Adrian-codeg/Mechatronics-robotics/README.md

Aim and Objectives:
Building a 3 degree-of-freedom robot for drawing on the board and return to inital point.

Method:
The project included the following components:

CAD design a 3 degree-of-freedom robot for drawing and assemble thems with motors and microcontroller.

Programming in the Arduino.

Communicating between them through a serial communication.

Adding some other addtionally features for more points.

Result:





Untitled video - Made with Clipchamp (2)

Note:
The CAD design was done on Fusion360: [https://github.com/Adrian-codeg/Mechatronics-robotics/blob/main/Mechatronics%20designs%20group%202.zip](https://grabcad.com/library/mechatronics-robotics-1)

Link for final result: https://www.youtube.com/watch?v=gOB_Nq9NREc
Code for arduino: https://github.com/Adrian-codeg/Mechatronics-robotics/tree/main/planB_v4
