Adrian-codeg/Mechatronics-robotics/Mechatronics designs on Fusion 360 group 2/down chassis v1 v10.step

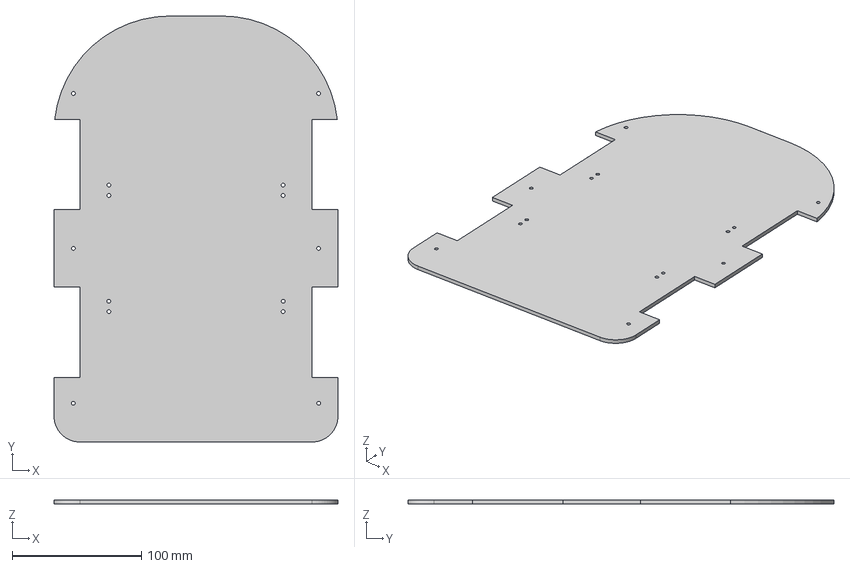
[picture p5: CAD file, 2025-03-02]
Mechatronics designs on Fusion 360 group 2/down chassis v1 v10.step
220.0 x 330.0 x 3.20 mm
