Adrian-codeg/Mechatronics-robotics/Mechatronics designs on Fusion 360 group 2/first part of the arm v18.step

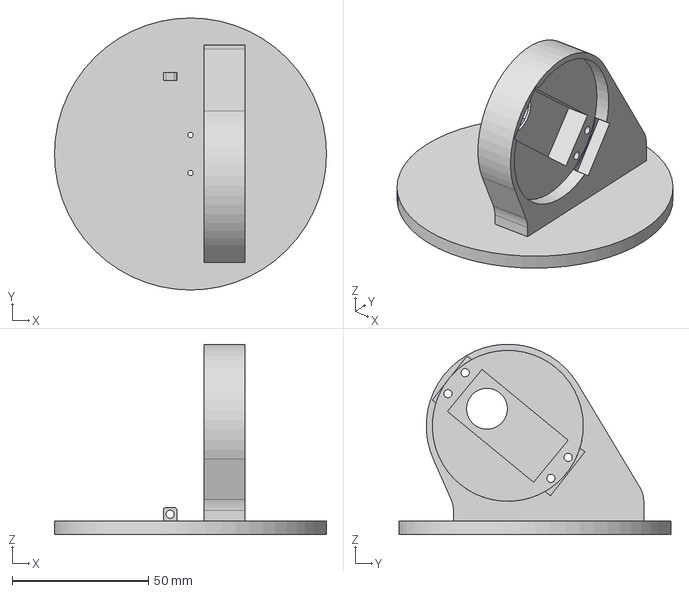
[picture p6: CAD file, 2025-03-02]
Mechatronics designs on Fusion 360 group 2/first part of the arm v18.step
100.0 x 100.0 x 70.0 mm
