Adrian-codeg/Mechatronics-robotics/Mechatronics designs on Fusion 360 group 2/dc motor connector v4.step

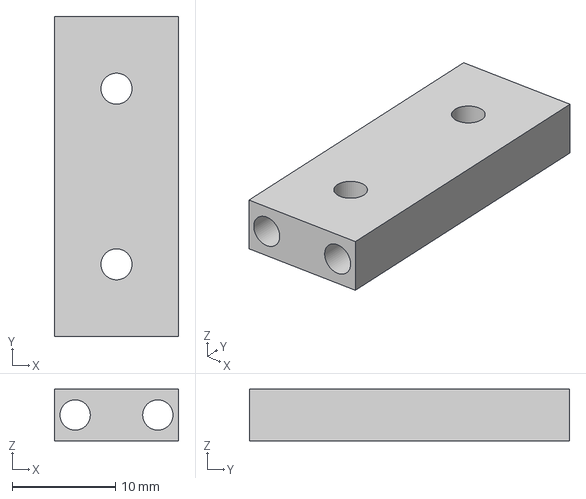
[picture p7: CAD file, 2025-03-02]
Mechatronics designs on Fusion 360 group 2/dc motor connector v4.step
12.0 x 31.0 x 5.00 mm
