Adrian-codeg/Mechatronics-robotics/Mechatronics designs on Fusion 360 group 2/gear v2.step

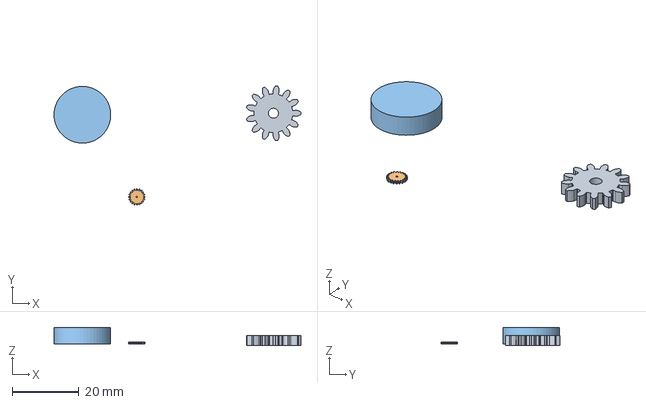
[picture p8: CAD file, 2025-03-02]
Mechatronics designs on Fusion 360 group 2/gear v2.step
74.0 x 35.8 x 5.49 mm
Spur Gear (13 teeth)
Spur Gear (20 teeth)
