Adrian-codeg/Mechatronics-robotics/Mechatronics designs on Fusion 360 group 2/upper chassis v1 v14.step

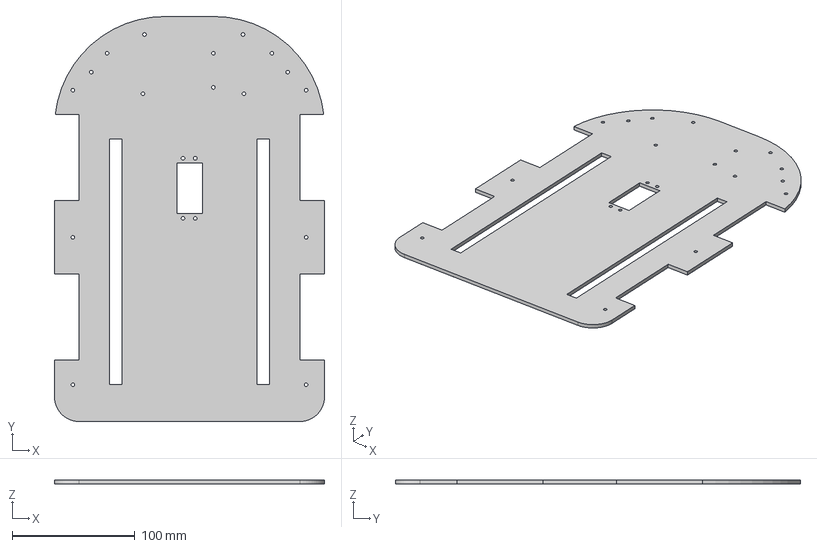
[picture p9: CAD file, 2025-03-02]
Mechatronics designs on Fusion 360 group 2/upper chassis v1 v14.step
220.0 x 330.0 x 3.20 mm
