Adrian-codeg/Mechatronics-robotics/Mechatronics designs on Fusion 360 group 2/Last arm part_.step

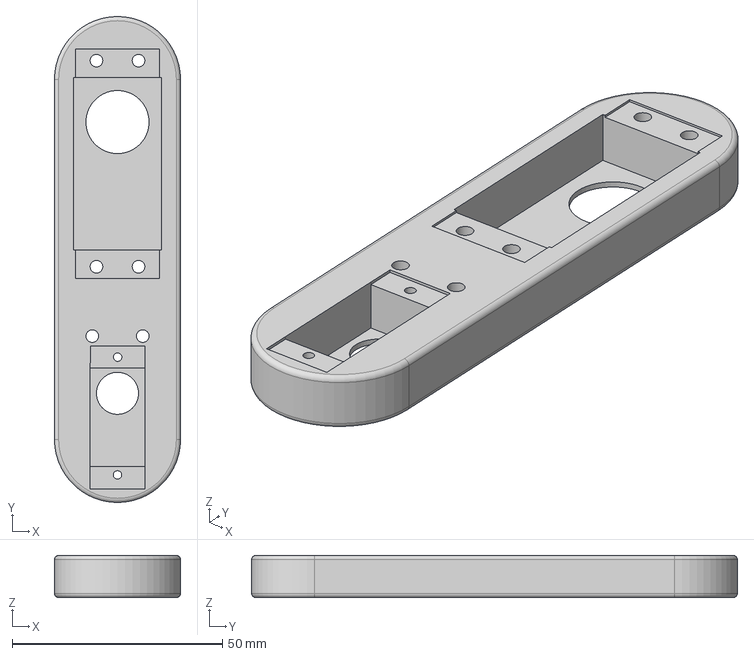
[picture p10: CAD file, 2025-03-02]
Mechatronics designs on Fusion 360 group 2/Last arm part_.step
30.0 x 115.6 x 10.0 mm
