Adrian-codeg/Mechatronics-robotics/Mechatronics designs on Fusion 360 group 2/Ir connector v1.step

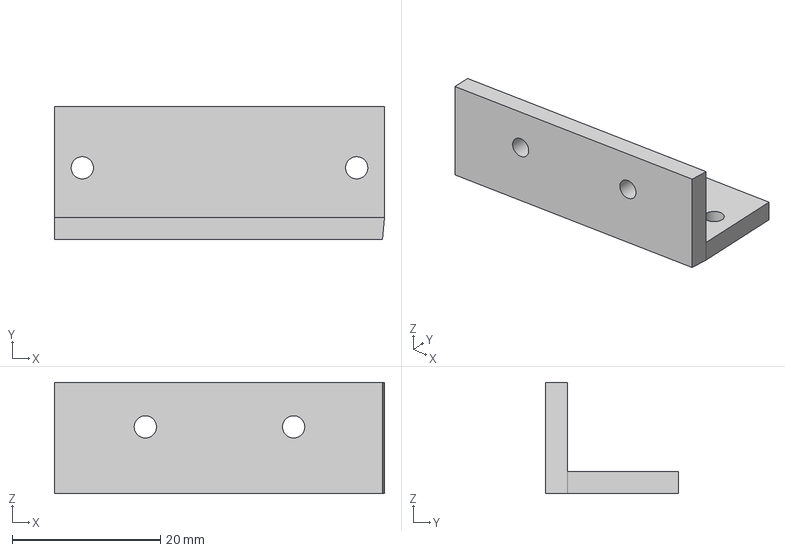
[picture p11: CAD file, 2025-03-02]
Mechatronics designs on Fusion 360 group 2/Ir connector v1.step
44.5 x 18.0 x 15.0 mm
