Adrian-codeg/Mechatronics-robotics/Mechatronics designs on Fusion 360 group 2/second arm part v2.step

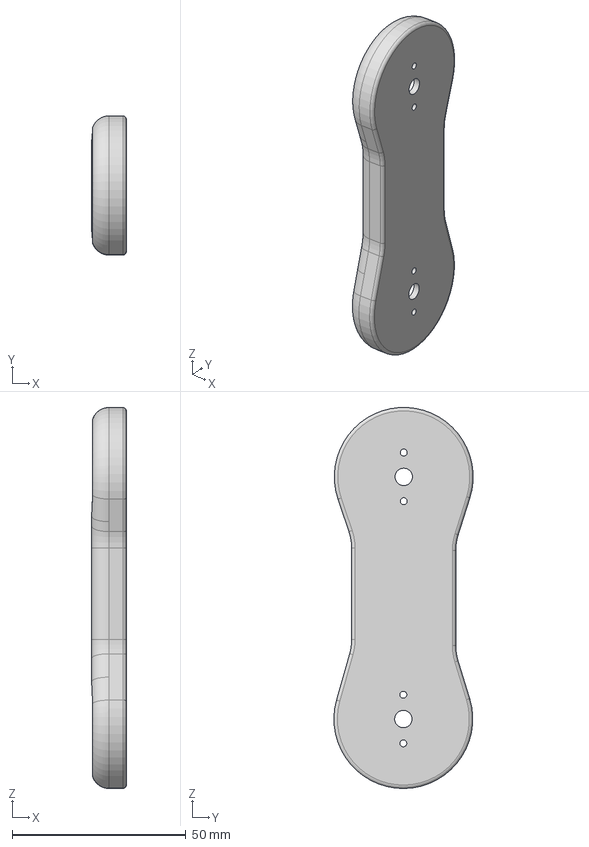
[picture p12: CAD file, 2025-03-02]
Mechatronics designs on Fusion 360 group 2/second arm part v2.step
10.0 x 40.1 x 109.7 mm
